Eduardo-V-Argenton/8bitdo-ultimate2-wireless-to-gp2040-adapter/schematics/8bitdo2ps4.kicad_sch

## KiCad design schematics/8bitdo2ps4.kicad_sch (2026-11-08)

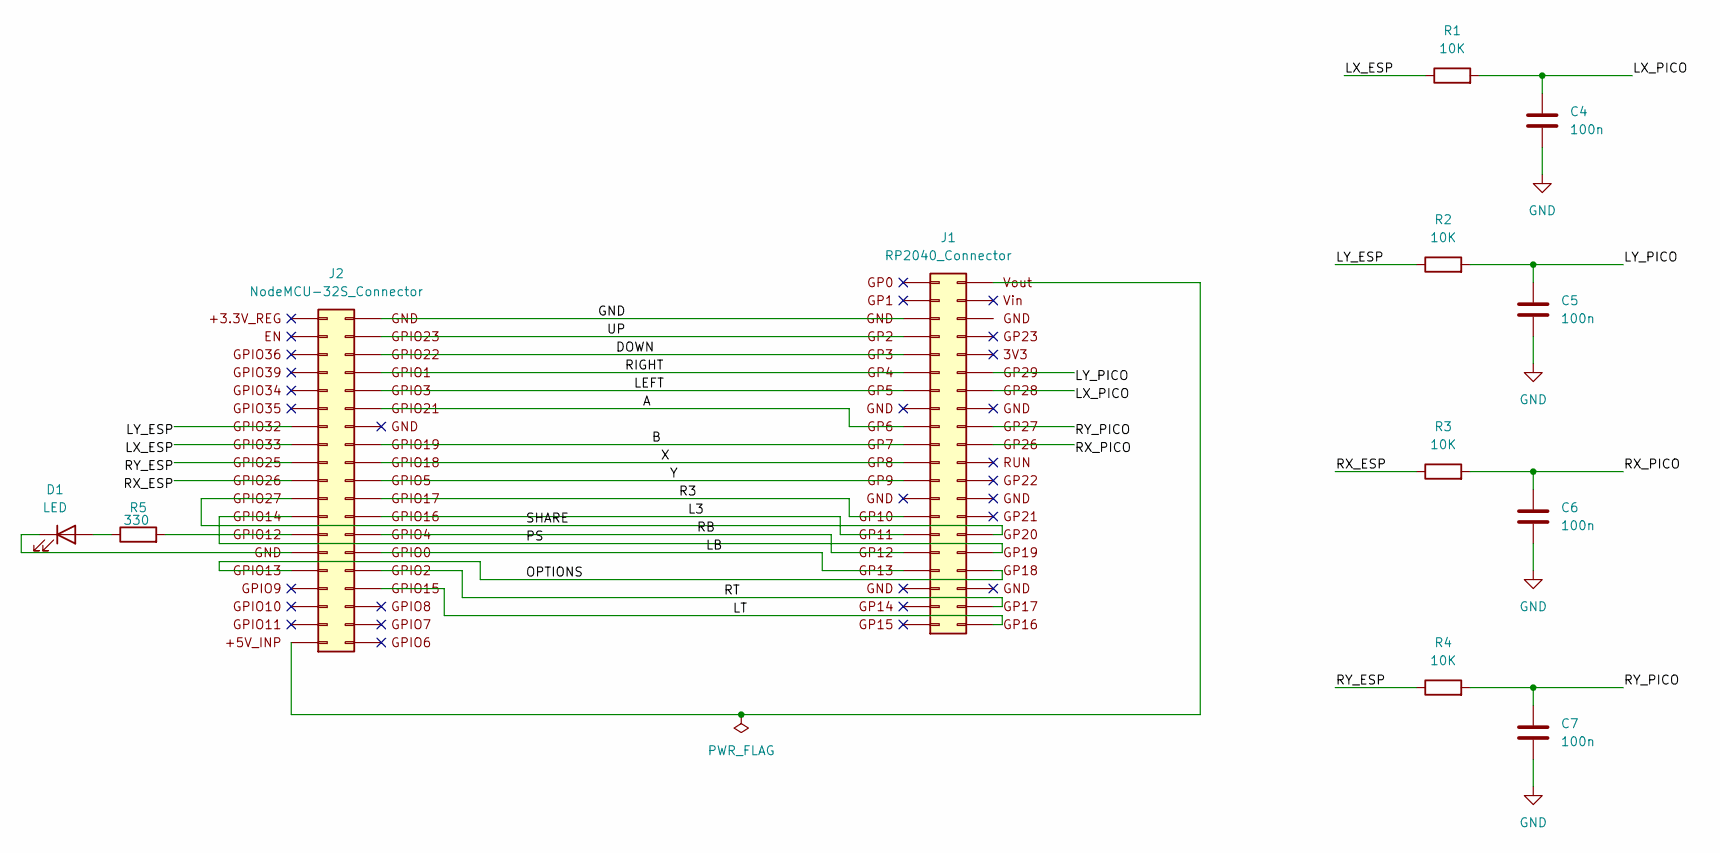
[picture p1: schematic 8bitdo2ps4.kicad_sch]

Parts:
C4, C5, C6, C7: 100n; C_Disc_D5.0mm_W2.5mm_P5.00mm
D1: LED
J1: RP2040_Connector
J2: NodeMCU-32S_Connector
R1, R2, R3, R4: 10K; R_Axial_DIN0207_L6.3mm_D2.5mm_P10.16mm_Horizontal
R5: 330

Connections:
A: J1.9 (GP6), J2.33 (GPIO21)
B: J1.10 (GP7), J2.31 (GPIO19)
DOWN: J1.5 (GP3), J2.36 (GPIO22)
GND: C4.2, C5.2, C6.2, C7.2, J1.3 (GND), J2.38 (GND)
L3: J1.15 (GP11), J2.27 (GPIO16)
LB: J1.17 (GP13), J2.25 (GPIO0)
LEFT: J1.7 (GP5), J2.34 (GPIO3)
LT: J1.21 (GP16), J2.23 (GPIO15)
LX_ESP: J2.8 (GPIO33), R1.1
LX_PICO: C4.1, J1.34 (GP28), R1.2
LY_ESP: J2.7 (GPIO32), R2.1
LY_PICO: C5.1, J1.35 (GP29), R2.2
unnamed: D1.1 (K), J2.14 (GND)
unnamed: D1.2 (A), R5.1
unnamed: J1.40 (Vout), J2.19 (+5V_INP)
unnamed: J2.13 (GPIO12), R5.2
OPTIONS: J1.24 (GP18), J2.15 (GPIO13)
PS: J1.25 (GP19), J2.12 (GPIO14)
R3: J1.14 (GP10), J2.28 (GPIO17)
RB: J1.16 (GP12), J2.26 (GPIO4)
RIGHT: J1.6 (GP4), J2.35 (GPIO1)
RT: J1.22 (GP17), J2.24 (GPIO2)
RX_ESP: J2.10 (GPIO26), R3.1
RX_PICO: C6.1, J1.31 (GP26), R3.2
RY_ESP: J2.9 (GPIO25), R4.1
RY_PICO: C7.1, J1.32 (GP27), R4.2
SHARE: J1.26 (GP20), J2.11 (GPIO27)
UP: J1.4 (GP2), J2.37 (GPIO23)
X: J1.11 (GP8), J2.30 (GPIO18)
Y: J1.12 (GP9), J2.29 (GPIO5)
