Eduardo-V-Argenton/8bitdo-ultimate2-wireless-to-gp2040-adapter/src/8bitdo_ultimate2_wireless_map.cpp

#include <Arduino.h>
#include "8bitdo_ultimate2_wireless_map.hpp"
#include "debug.hpp"

void map_gamepad(GamepadState& gamepad, uint8_t* report)
{
    gamepad.a = report[7] & 0x01;
    gamepad.b = report[7] & 0x02;
    gamepad.x = report[7] & 0x08;
    gamepad.y = report[7] & 0x10;

    uint8_t dpad = report[0];
    gamepad.dup = dpad == 0x00 || dpad == 0x01 || dpad == 0x07;
    gamepad.ddown = dpad == 0x03 || dpad == 0x04 || dpad == 0x05;
    gamepad.dright = dpad == 0x01 || dpad == 0x02 || dpad == 0x03;
    gamepad.dleft = dpad == 0x05 || dpad == 0x06 || dpad == 0x07;

    gamepad.lax = report[1];
    gamepad.lay = report[2];
    gamepad.rax = report[3];
    gamepad.ray = report[4];
    

    gamepad.rb = report[7] & 0x80;
    gamepad.lb = report[7] & 0x40;
    
    gamepad.rt = report[5];
    gamepad.lt = report[6];
    
    gamepad.rt_b = report[8] & 0x02;
    gamepad.lt_b = report[8] & 0x01;
    
    gamepad.share  = report[8] & 0x04;
    gamepad.options = report[8] & 0x08;
    gamepad.ps     = report[8] & 0x10;
    
    gamepad.rap     = report[8] & 0x40;
    gamepad.lap    = report[8] & 0x20;
}

void test_bool_buttons(GamepadState& gamepad)
{
    if(gamepad.a){DEBUG_PRINTLN("A");}
    if(gamepad.b){DEBUG_PRINTLN("B");}
    if(gamepad.x){DEBUG_PRINTLN("X");}
    if(gamepad.y){DEBUG_PRINTLN("Y");}
    if(gamepad.lb){DEBUG_PRINTLN("LB");}
    if(gamepad.rb){DEBUG_PRINTLN("RB");}
    if(gamepad.lt_b){DEBUG_PRINTLN("LT");}
    if(gamepad.rt_b){DEBUG_PRINTLN("RT");}
    if(gamepad.share){DEBUG_PRINTLN("SHARE");}
    if(gamepad.options){DEBUG_PRINTLN("OPTIONS");}
    if(gamepad.ps){DEBUG_PRINTLN("PS");}
    if(gamepad.rap){DEBUG_PRINTLN("RAP");}
    if(gamepad.lap){DEBUG_PRINTLN("LAP");}
    if(gamepad.dup){DEBUG_PRINTLN("UP");}
    if(gamepad.ddown){DEBUG_PRINTLN("DOWN");}
    if(gamepad.dleft){DEBUG_PRINTLN("LEFT");}
    if(gamepad.dright){DEBUG_PRINTLN("RIGHT");}
}

void test_sticks(GamepadState& gamepad)
{
    DEBUG_PRINTF("LX:%3u LY:%3u RX:%3u RY:%3u\n",
        gamepad.lax,
        gamepad.lay,
        gamepad.rax,
        gamepad.ray
    );
}

void test_triggers(GamepadState& gamepad)
{
    DEBUG_PRINTF("RT:%d LT:%d\n",
        gamepad.rt,
        gamepad.lt
    );
}
