Eduardo-V-Argenton/8bitdo-ultimate2-wireless-to-gp2040-adapter/(commit log)

2026-09-28 Boolean buttons working
2026-10-18 Make the firmware robust to disconnects and boot glitches
    - Remove the boot LED blink on GPIO2, which is PIN_OPTIONS and pressed
    Options five times on every boot.
    - Configure the outputs before BLE starts, with buttons released and
    sticks centered, so the RP2040 doesn't read floating pins while scanning.
    - Release everything and restart when the controller disconnects, instead
    of keeping the last state (stuck buttons).
    - Bound the report copy to the buffer size, ignore reports too short to be
    the gamepad report, and hand the report from the BLE task to loop()
    under a critical section.
    - Restart when the HID service is missing instead of idling forever.
    - Raise the stick PWM to 78.1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
2026-10-18 Fix stick centering, cut boot current, add a status LED
    - Rescale each stick axis to the RP2040 ADC on this board, which reads
    full scale at about 3.03V instead of 3.3V. Rest now lands on the ADC
    midpoint (~1.51V) and both directions reach full deflection; before,
    sticks rested at +0.12 and the negative side stopped at about -0.87.
    - Run the CPU at 80 MHz and BLE TX power at 0 dBm to lower the current
    spikes at BLE start.
    - Optional status LED on GPIO12 (LED + 330R to GND): blinks the last
    reset reason at boot (3 fast = brownout, 2 slow = software restart,
    1 slow = power on, 5 fast = other), then stays on once connected.
2026-10-18 Rewrite the README with a diagram, wiring and setup guide
    Replace the ASCII architecture with an SVG diagram (light and dark
    themes) and document how the adapter works, the full ESP32 / RP2040 /
    GP2040-CE pin table, power, the GP2040-CE settings for PS4 with
    DualShock 4 USB passthrough, building, the status LED codes, stick
    calibration and known limitations.
2026-11-08 remap + schematics
2026-11-08 Revise README with updated wiring and configuration
    Updated wiring and configuration details for ESP32 and RP2040 integration. Revised power requirements and clarified known limitations.
2026-11-08 remove unnecessary capacitors
